EE-Emerge/EE-Emerge2022_LaserHarp/FFT/Display_system_schematic_[DRAFT]_picture.png

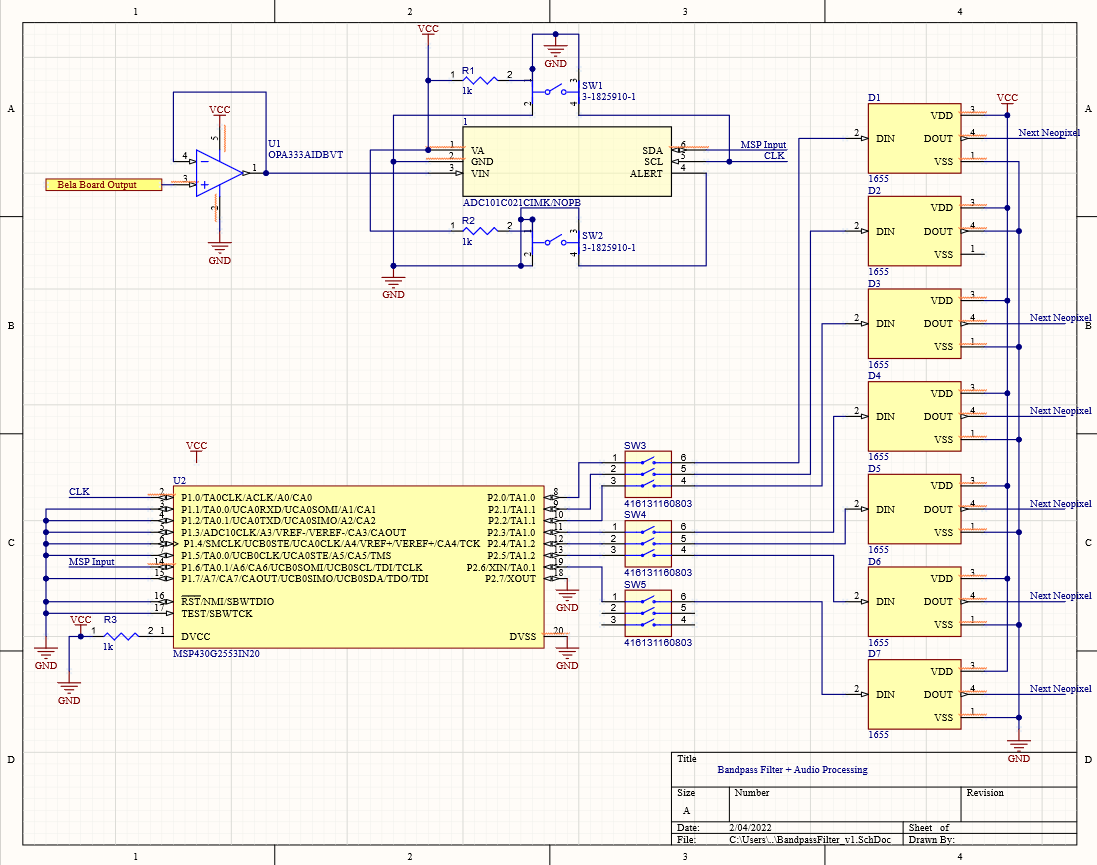
FFT/Display_system_schematic_[DRAFT]_picture.png
