EE-Emerge/EE-Emerge2022_LaserHarp/Sensor_PCB/SensorCircuitV2.png

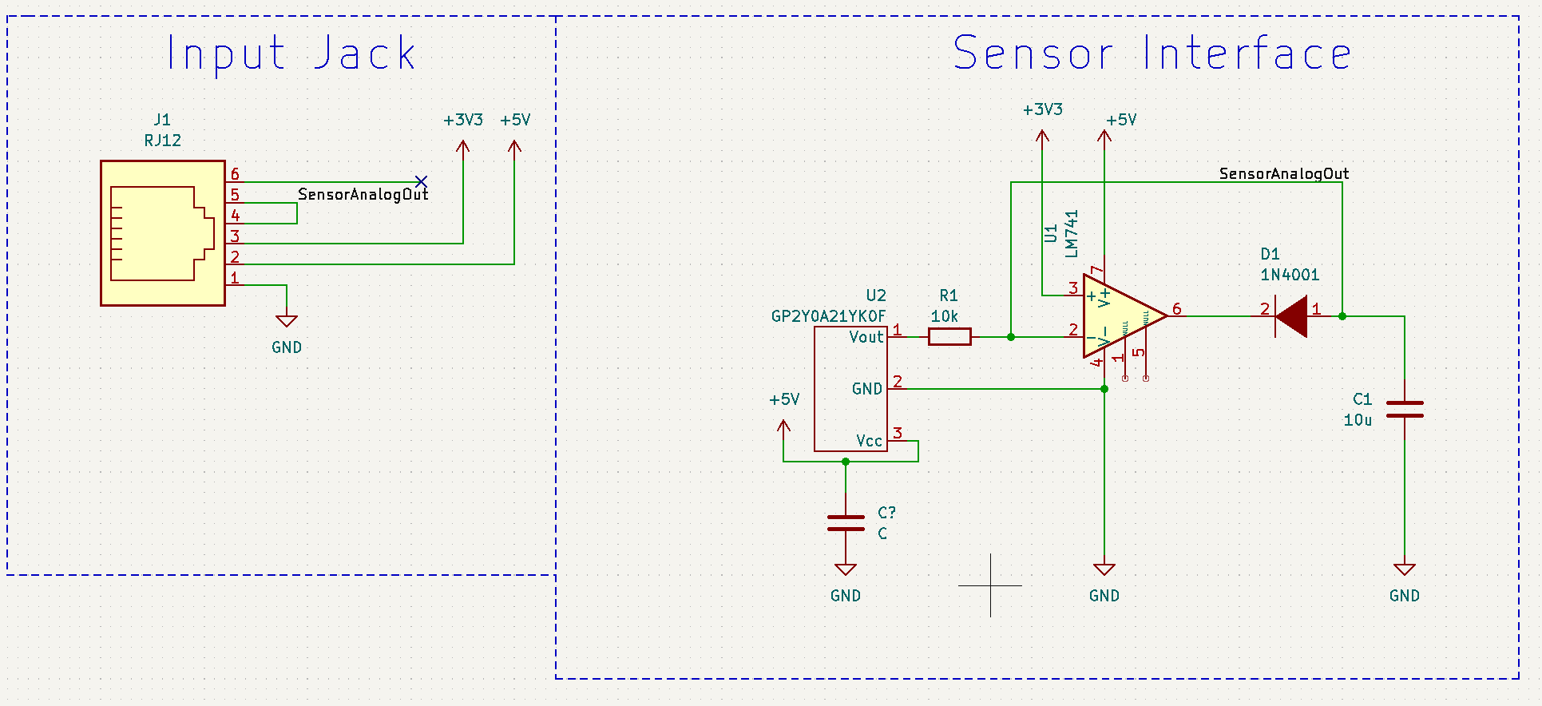
Sensor_PCB/SensorCircuitV2.png
