EE-Emerge/EE-Emerge2022_LaserHarp/Sensor_PCB/SensorToBelaCircuit.png

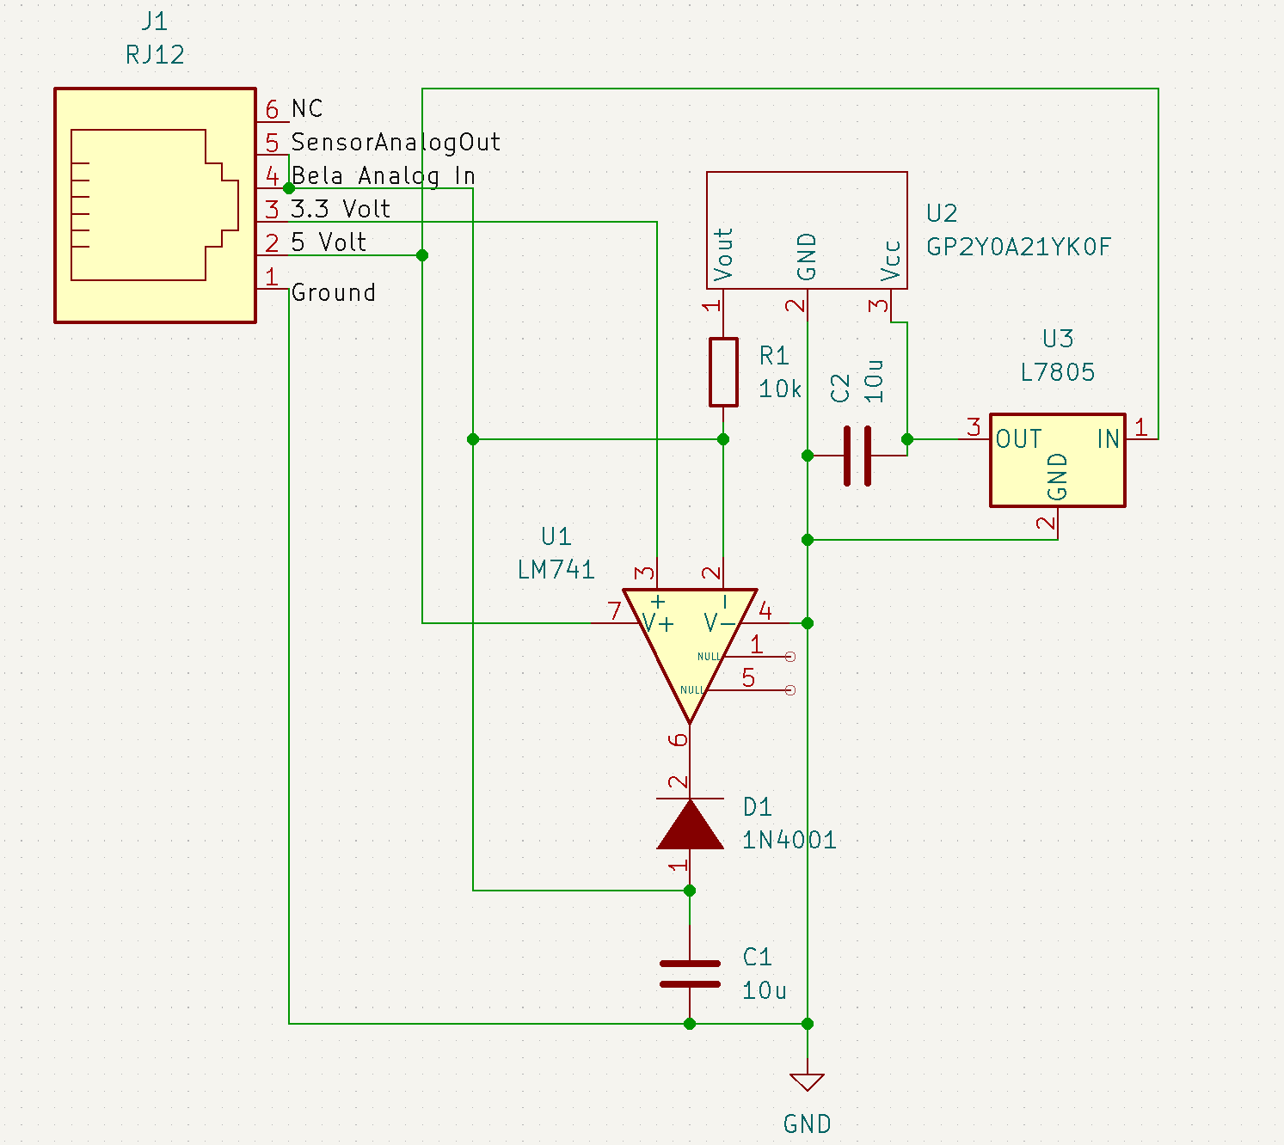
Sensor_PCB/SensorToBelaCircuit.png
