EE-Emerge/EE-Emerge2022_LaserHarp/Parts_Lists/Harp Parts List.csv

Part | Quantity | Price | Link
Distance Sensors | 7 - 8 | $11 ea. | https://www.pololu.com/product/2464
Outer Casing Opaque Acrylic | ?? | ?? | https://amazon.com/dp/B0851SSKCD
Transparent Acrylic Cover | 1 sheet | ~$20 | https://amazon.com/dp/B01NAFYNV4/
Pitchbend Potentiometer | 1 | $8 | https://amazon.com/dp/B09DNTRDKT/
Plastic Liner for Cover | ?? | $24 for a 4-pack | https://amazon.com/dp/B07MT4WNP7/
Velcro Dots to Hold Sensors in Place | 15/pack | 2.89 for 1 pack | https://www.amazon.com/dp/B002IXGUAQ/
