EE-Emerge/EE-Emerge2022_LaserHarp/Parts_Lists/BandPass_Display_Parts_List.csv

Part | Quantity | Price | Link
LM741 Op-Amp | ??? | ??? | ???
MSP430 | 8 | ??? | ???
DIP Switches | 1(pack of 20) | $5.99 | https://amzn.to/34qka1C
Resistors | ??? | ??? | ???
Switches | ??? | ??? | ???
