EE-Emerge/EE-Emerge2022_LaserHarp/Mechanical/Bela Housing/BackWall.dxf

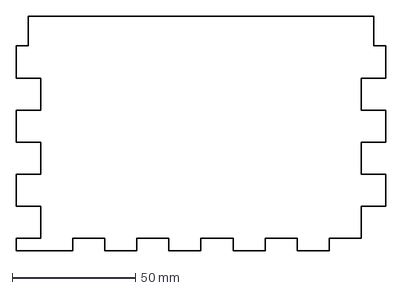
[picture p6: CAD file, 2022-06-02]
Mechanical/Bela Housing/BackWall.dxf
150.0 x 95.0 mm
