EE-Emerge/EE-Emerge2022_LaserHarp/Mechanical/Main Module/Base.dxf

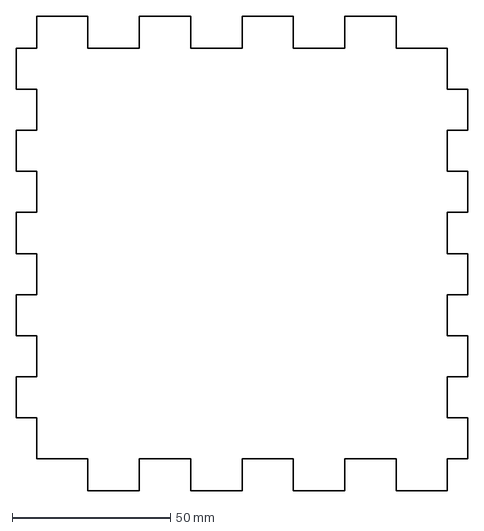
[picture p7: CAD file, 2022-06-02]
Mechanical/Main Module/Base.dxf
142.7 x 150.0 mm
