EE-Emerge/EE-Emerge2022_LaserHarp/Mechanical/Speaker Housing/innerShelf.dxf

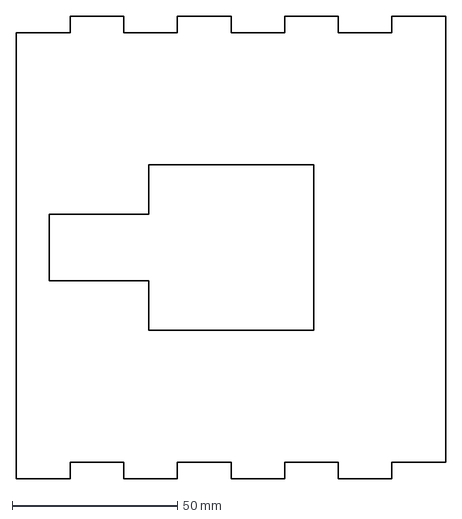
[picture p8: CAD file, 2022-06-02]
Mechanical/Speaker Housing/innerShelf.dxf
130.0 x 140.0 mm
