EE-Emerge/EE-Emerge2022_LaserHarp/Mechanical/Bela Housing/Wall2.dxf

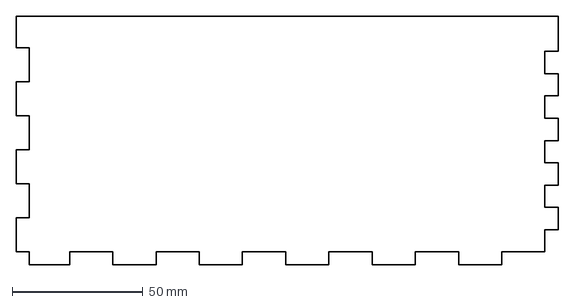
[picture p9: CAD file, 2022-06-02]
Mechanical/Bela Housing/Wall2.dxf
207.0 x 95.0 mm
