EE-Emerge/EE-Emerge2022_LaserHarp/Mechanical/Main Module/innerShelf.dxf

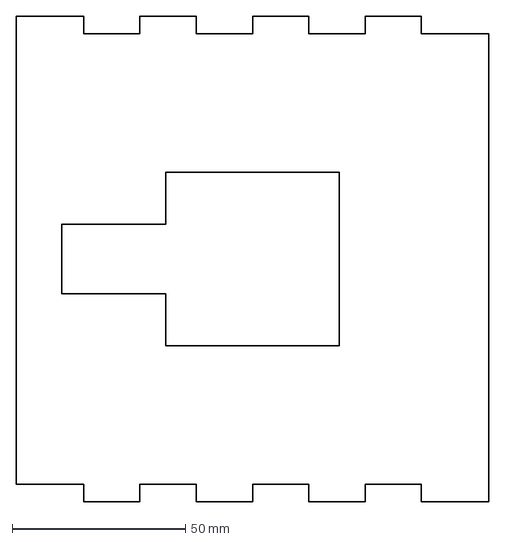
[picture p10: CAD file, 2022-06-02]
Mechanical/Main Module/innerShelf.dxf
136.3 x 140.0 mm
