EE-Emerge/EE-Emerge2022_LaserHarp/Mechanical/Speaker Housing/speakerBase.dxf

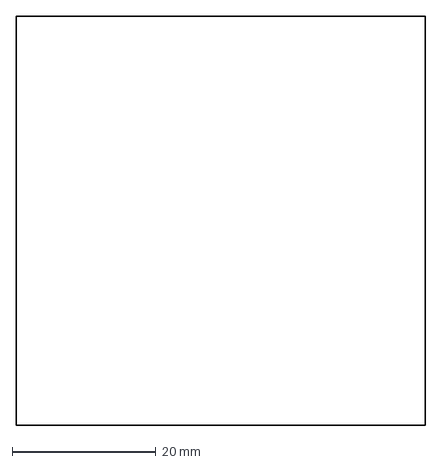
[picture p11: CAD file, 2022-06-02]
Mechanical/Speaker Housing/speakerBase.dxf
57.0 x 57.0 mm
