EE-Emerge/EE-Emerge2022_LaserHarp/Mechanical/Bela Housing/Wall2Support.dxf

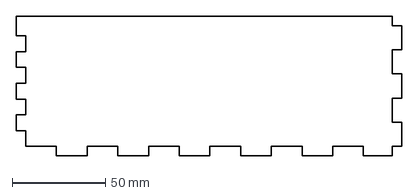
[picture p12: CAD file, 2022-06-02]
Mechanical/Bela Housing/Wall2Support.dxf
207.0 x 75.0 mm
