EE-Emerge/EE-Emerge2022_LaserHarp/Mechanical/Main Module/innerWall2.dxf

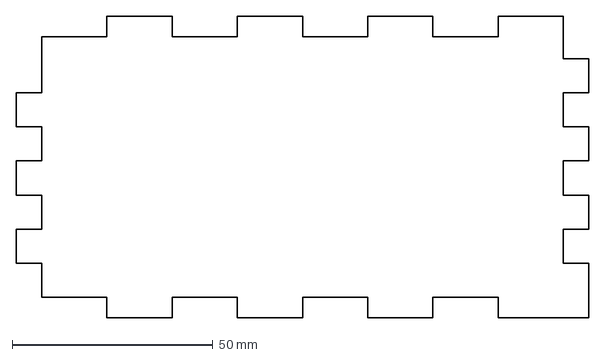
[picture p13: CAD file, 2022-06-02]
Mechanical/Main Module/innerWall2.dxf
142.7 x 75.0 mm
