EE-Emerge/EE-Emerge2022_LaserHarp/Mechanical/Speaker Housing/innerSolidWall.dxf

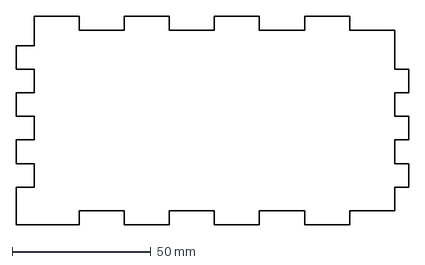
[picture p14: CAD file, 2022-06-02]
Mechanical/Speaker Housing/innerSolidWall.dxf
141.4 x 75.0 mm
