EE-Emerge/EE-Emerge2022_LaserHarp/Mechanical/Bela Housing/Wall1.dxf

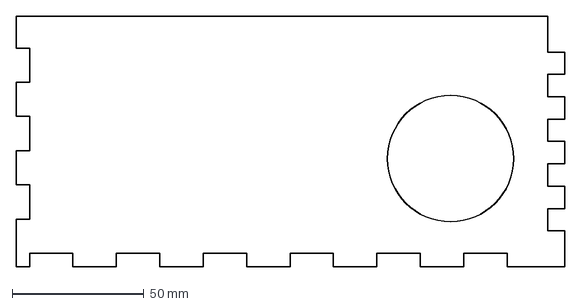
[picture p15: CAD file, 2022-06-02]
Mechanical/Bela Housing/Wall1.dxf
208.4 x 95.0 mm
