EE-Emerge/EE-Emerge2022_LaserHarp/Mechanical/Main Module/outerShelf.dxf

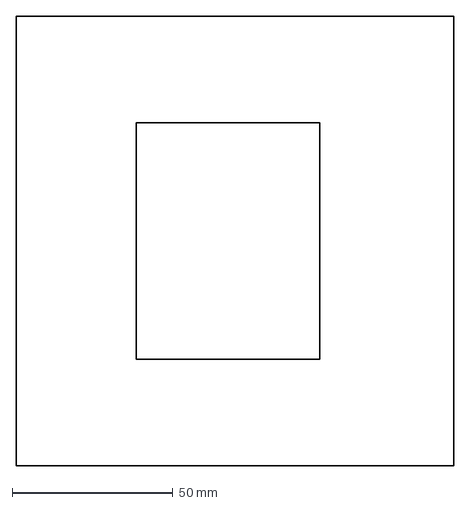
[picture p16: CAD file, 2022-06-02]
Mechanical/Main Module/outerShelf.dxf
136.3 x 140.0 mm
