EE-Emerge/EE-Emerge2022_LaserHarp/Mechanical/Speaker Housing/outerShelf.dxf

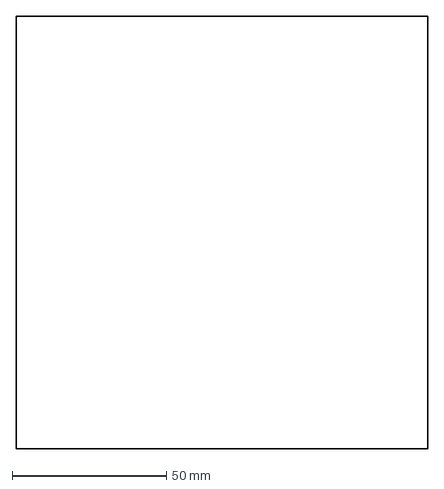
[picture p17: CAD file, 2022-06-02]
Mechanical/Speaker Housing/outerShelf.dxf
133.2 x 140.0 mm
