EE-Emerge/EE-Emerge2022_LaserHarp/Mechanical/Bela Housing/TopPlate.dxf

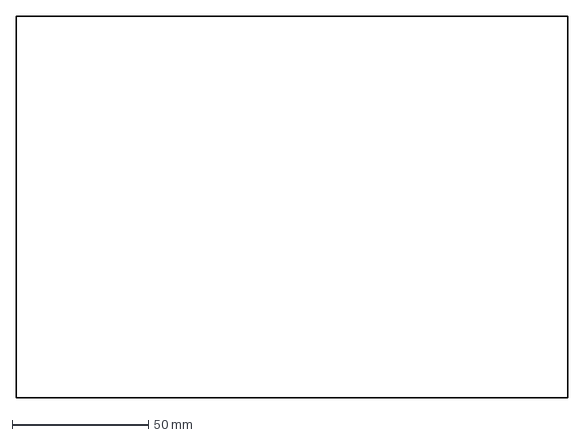
[picture p18: CAD file, 2022-06-02]
Mechanical/Bela Housing/TopPlate.dxf
202.0 x 140.0 mm
