EE-Emerge/EE-Emerge2022_LaserHarp/Mechanical/Speaker Housing/innerSpeakerWall.dxf

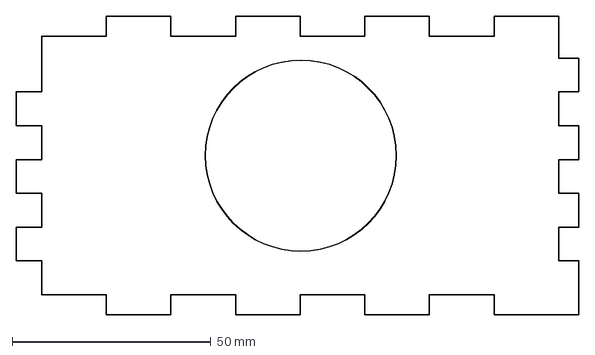
[picture p20: CAD file, 2022-06-02]
Mechanical/Speaker Housing/innerSpeakerWall.dxf
141.4 x 75.0 mm
