EE-Emerge/EE-Emerge2022_LaserHarp/Mechanical/Bela Housing/Wall1Support.dxf

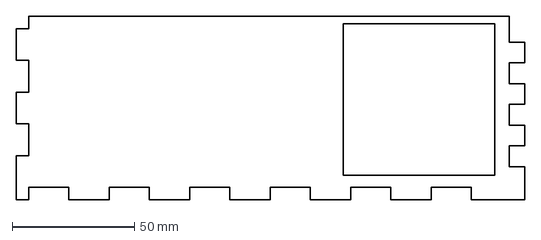
[picture p21: CAD file, 2022-06-02]
Mechanical/Bela Housing/Wall1Support.dxf
208.4 x 75.0 mm
