EE-Emerge/EE-Emerge2022_LaserHarp/Mechanical/Main Module/outerWall2.dxf

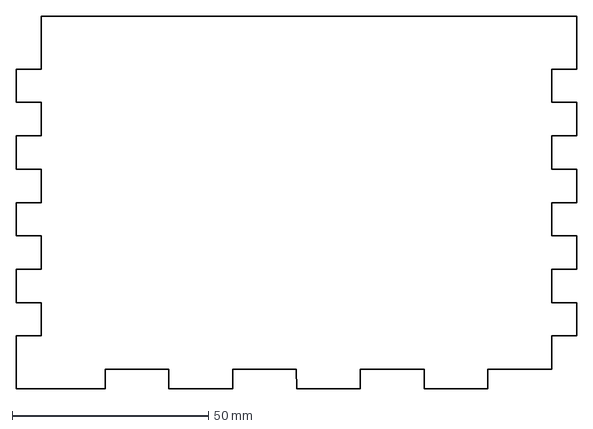
[picture p22: CAD file, 2022-06-02]
Mechanical/Main Module/outerWall2.dxf
142.7 x 95.0 mm
