EE-Emerge/EE-Emerge2022_LaserHarp/Mechanical/Speaker Housing/outerSpeakerWall.dxf

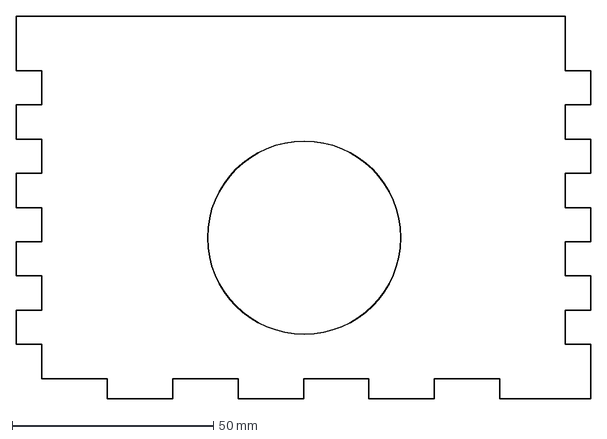
[picture p23: CAD file, 2022-06-02]
Mechanical/Speaker Housing/outerSpeakerWall.dxf
142.7 x 95.0 mm
