EE-Emerge/EE-Emerge2022_LaserHarp/Mechanical/Main Module/innerWall1.dxf

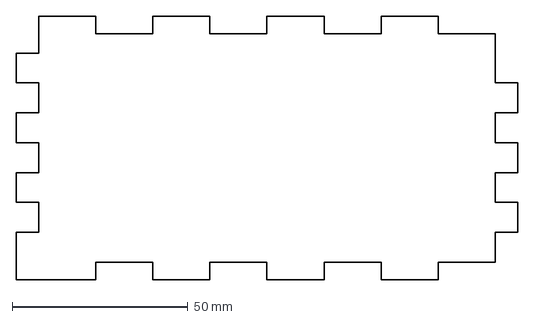
[picture p24: CAD file, 2022-06-02]
Mechanical/Main Module/innerWall1.dxf
142.7 x 75.0 mm
