EE-Emerge/EE-Emerge2022_LaserHarp/Mechanical/Speaker Housing/endWall.dxf

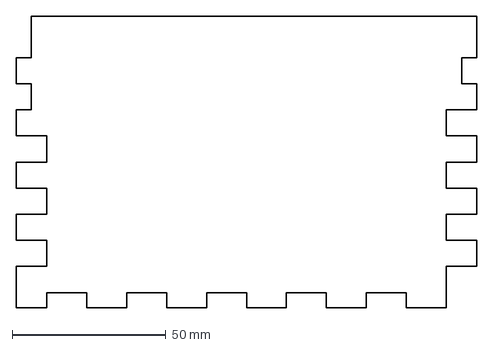
[picture p25: CAD file, 2022-06-02]
Mechanical/Speaker Housing/endWall.dxf
150.0 x 95.0 mm
