EE-Emerge/EE-Emerge2022_LaserHarp/Mechanical/Speaker Housing/outerSolidWall.dxf

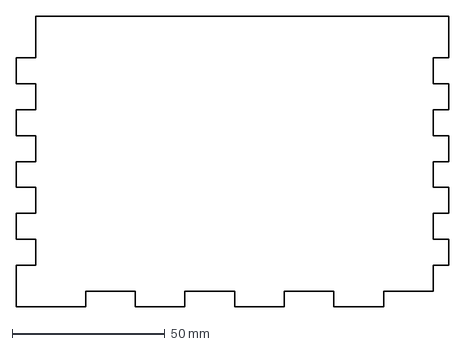
[picture p26: CAD file, 2022-06-02]
Mechanical/Speaker Housing/outerSolidWall.dxf
141.4 x 95.0 mm
