EE-Emerge/EE-Emerge2022_LaserHarp/Mechanical/Speaker Housing/base.dxf

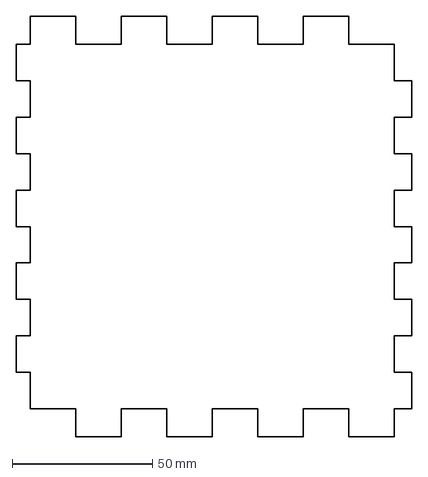
[picture p27: CAD file, 2022-06-02]
Mechanical/Speaker Housing/base.dxf
141.3 x 150.0 mm
