EE-Emerge/EE-Emerge2022_LaserHarp/(list of files, drawings)

Other design files:
FFT/DisplaySystem_v1.SchDoc
