EE-Emerge/EE-Emerge2022_LaserHarp/(commit log)

2022-02-10 Delete gp2y0a21yk0f_datasheet.pdf
    moved to sensor pcb folder
2022-02-11 Update Harp Parts List.csv
    [Harp Parts List.csv]
2022-02-18 Add files via upload
    ZIP files containing the gerber and drill files for making the PCB.
2022-05-20 Add files via upload
    KiCAD project for the Sensor PCB
2022-05-20 Add files via upload
    KiCAD project for the latest version of the Bela HAT PCB.
2022-05-20 Add files via upload
    OUT OF DATE version of the Bela HAT PCB.
2022-06-01 Update Hardware.md
    Finished adding the text for this page, still need a couple of complimentary images
2022-06-02 Update Mechanical.md
    description and images added, just needs image of completed bela housing
2022-06-02 Rename Mechanical/BackWall.dxf to Mechanical/Main Module/BackWall.dxf
    [BackWall.dxf]
2022-06-02 Rename Mechanical/Base.dxf to Mechanical/Main Module/Base.dxf
    [Base.dxf]
2022-06-02 Rename Mechanical/innerShelf.dxf to Mechanical/Main Module/innerShelf.dxf
    [innerShelf.dxf]
2022-06-02 Rename Mechanical/innerWall1.dxf to Mechanical/Main Module/innerWall1.dxf
    [innerWall1.dxf]
2022-06-02 Rename Mechanical/innerWall2.dxf to Mechanical/Main Module/innerWall2.dxf
    [innerWall2.dxf]
2022-06-02 Rename Mechanical/outerShelf.dxf to Mechanical/Main Module/outerShelf.dxf
    [outerShelf.dxf]
2022-06-02 Rename Mechanical/outerWall1.dxf to Mechanical/Main Module/outerWall1.dxf
    [outerWall1.dxf]
2022-06-02 Rename Mechanical/outerWall2.dxf to Mechanical/Main Module/outerWall2.dxf
    [outerWall2.dxf]
2022-06-02 Rename Mechanical/Main Module/BackWall.dxf to Mechanical/Bela Housing/BackWall.dxf
    [BackWall.dxf]
2022-06-02 Rename Mechanical/TopPlate.dxf to Mechanical/Bela Housing/TopPlate.dxf
    [TopPlate.dxf]
2022-06-02 Rename Mechanical/Wall1.dxf to Mechanical/Bela Housing/Wall1.dxf
    [Wall1.dxf]
2022-06-02 Rename Mechanical/Wall1Support.dxf to Mechanical/Bela Housing/Wall1Support.dxf
    [Wall1Support.dxf]
2022-06-02 Rename Mechanical/Wall2.dxf to Mechanical/Bela Housing/Wall2.dxf
    [Wall2.dxf]
2022-06-02 Rename Mechanical/Wall2Support.dxf to Mechanical/Bela Housing/Wall2Support.dxf
    [Wall2Support.dxf]
2022-06-02 Rename Mechanical/base.dxf to Mechanical/Speaker Housing/base.dxf
    [base.dxf]
